samvangysegem/usb2uart-hardware/manufacturing/usb2uart-kicad.csv

Designator | Qty | Comment | Footprint | Manufacturer | MPN | LCSC Part #
C1,C2,C3,C4,C5,C6,C8,C12 | 8 | 0.1u | Capacitor_SMD:C_0402_1005Metric | Samsung | CL05B104KO5NNNC | C1525
C7 | 1 | 10u | Capacitor_SMD:C_0805_2012Metric_Pad1.18x1.45mm_HandSolder | Samsung | CL21A106KAYNNNE | C15850
C9 | 1 | 10u | Capacitor_SMD:C_0805_2012Metric | Samsung | CL21A106KAYNNNE | C15850
C10,C11 | 2 | 16p | Capacitor_SMD:C_0402_1005Metric | FH (Guangdong Fenghua Advanced Tech) | 0402CG150J500NT | C1548
D1 | 1 | TPD1E10B06 | Package_SON:Texas_DPY0002A_0.6x1mm_P0.65mm | Texas Instruments | TPD1E10B06DPYR | C48260
D2,D3,D4,D5,D6,D7,D8 | 7 | TPD2E2U06 | Package_TO_SOT_SMD:SOT-323_SC-70 | Texas Instruments | TPD2E2U06QDCKRQ1 | C915089
D9 | 1 | ACT_B | LED_SMD:LED_0603_1608Metric | Hubei KENTO Elec | KT-0603B | C2288
D10 | 1 | TX_R | LED_SMD:LED_0603_1608Metric | Hubei KENTO Elec | KT-0603R | C2286
D11 | 1 | RX_G | LED_SMD:LED_0603_1608Metric | Hubei KENTO Elec | KT-0603G | C12624
D12 | 1 | PWR_G | LED_SMD:LED_0603_1608Metric | Hubei KENTO Elec | KT-0603G | C12624
J1 | 1 | USB_C_16P | Connector_USB:USB_C_Receptacle_GCT_USB4105-xx-A_16P_TopMnt_Horizontal | SHOU HAN | TYPE-C 16PIN 2MD(073) | C2765186
J2,J3 | 2 | 530480510 | Connector_Molex:Molex_PicoBlade_53048-0510_1x05_P1.25mm_Horizontal | Molex | 530480510 | C588276
J4,J5 | 2 | 530480310 | Connector_Molex:Molex_PicoBlade_53048-0310_1x03_P1.25mm_Horizontal | MOLEX | 530480310 | C505275
R1,R2,R8,R9,R10 | 5 | 5k1 | Resistor_SMD:R_0402_1005Metric | UNI-ROYAL(Uniroyal Elec) | 0402WGF5101TCE | C25905
R3 | 1 | 0R | Resistor_SMD:R_0805_2012Metric_Pad1.20x1.40mm_HandSolder | UNI-ROYAL(Uniroyal Elec) | 0805W8F0000T5E | C17477
R4 | 1 | 390 | Resistor_SMD:R_0603_1608Metric_Pad0.98x0.95mm_HandSolder | UNI-ROYAL(Uniroyal Elec) | 0603WAF3900T5E | C23151
R5 | 1 | 820 | Resistor_SMD:R_0603_1608Metric_Pad0.98x0.95mm_HandSolder | UNI-ROYAL(Uniroyal Elec) | 0603WAF8200T5E | C23253
R6,R7 | 2 | 510 | Resistor_SMD:R_0603_1608Metric_Pad0.98x0.95mm_HandSolder | UNI-ROYAL(Uniroyal Elec) | 0603WAF5100T5E | C23193
U1 | 1 | CH344Q | Package_QFP:LQFP-48_7x7mm_P0.5mm | WCH | CH344Q | C2988084
U2 | 1 | SPX3819M5-L-3-3 | Package_TO_SOT_SMD:SOT-23-5 | MaxLinear | SPX3819M5-L-3-3/TR | C9055
X1 | 1 | 8MHz | Crystal:Crystal_SMD_3225-4Pin_3.2x2.5mm | YXC Crystal Oscillators | X32258MOB4SI | C2682775
