samvangysegem/usb2uart-hardware/usb2uart-kicad/usb2uart-kicad.kicad_pcb

## KiCad design usb2uart-kicad/usb2uart-kicad.kicad_pcb (2026-10-05)

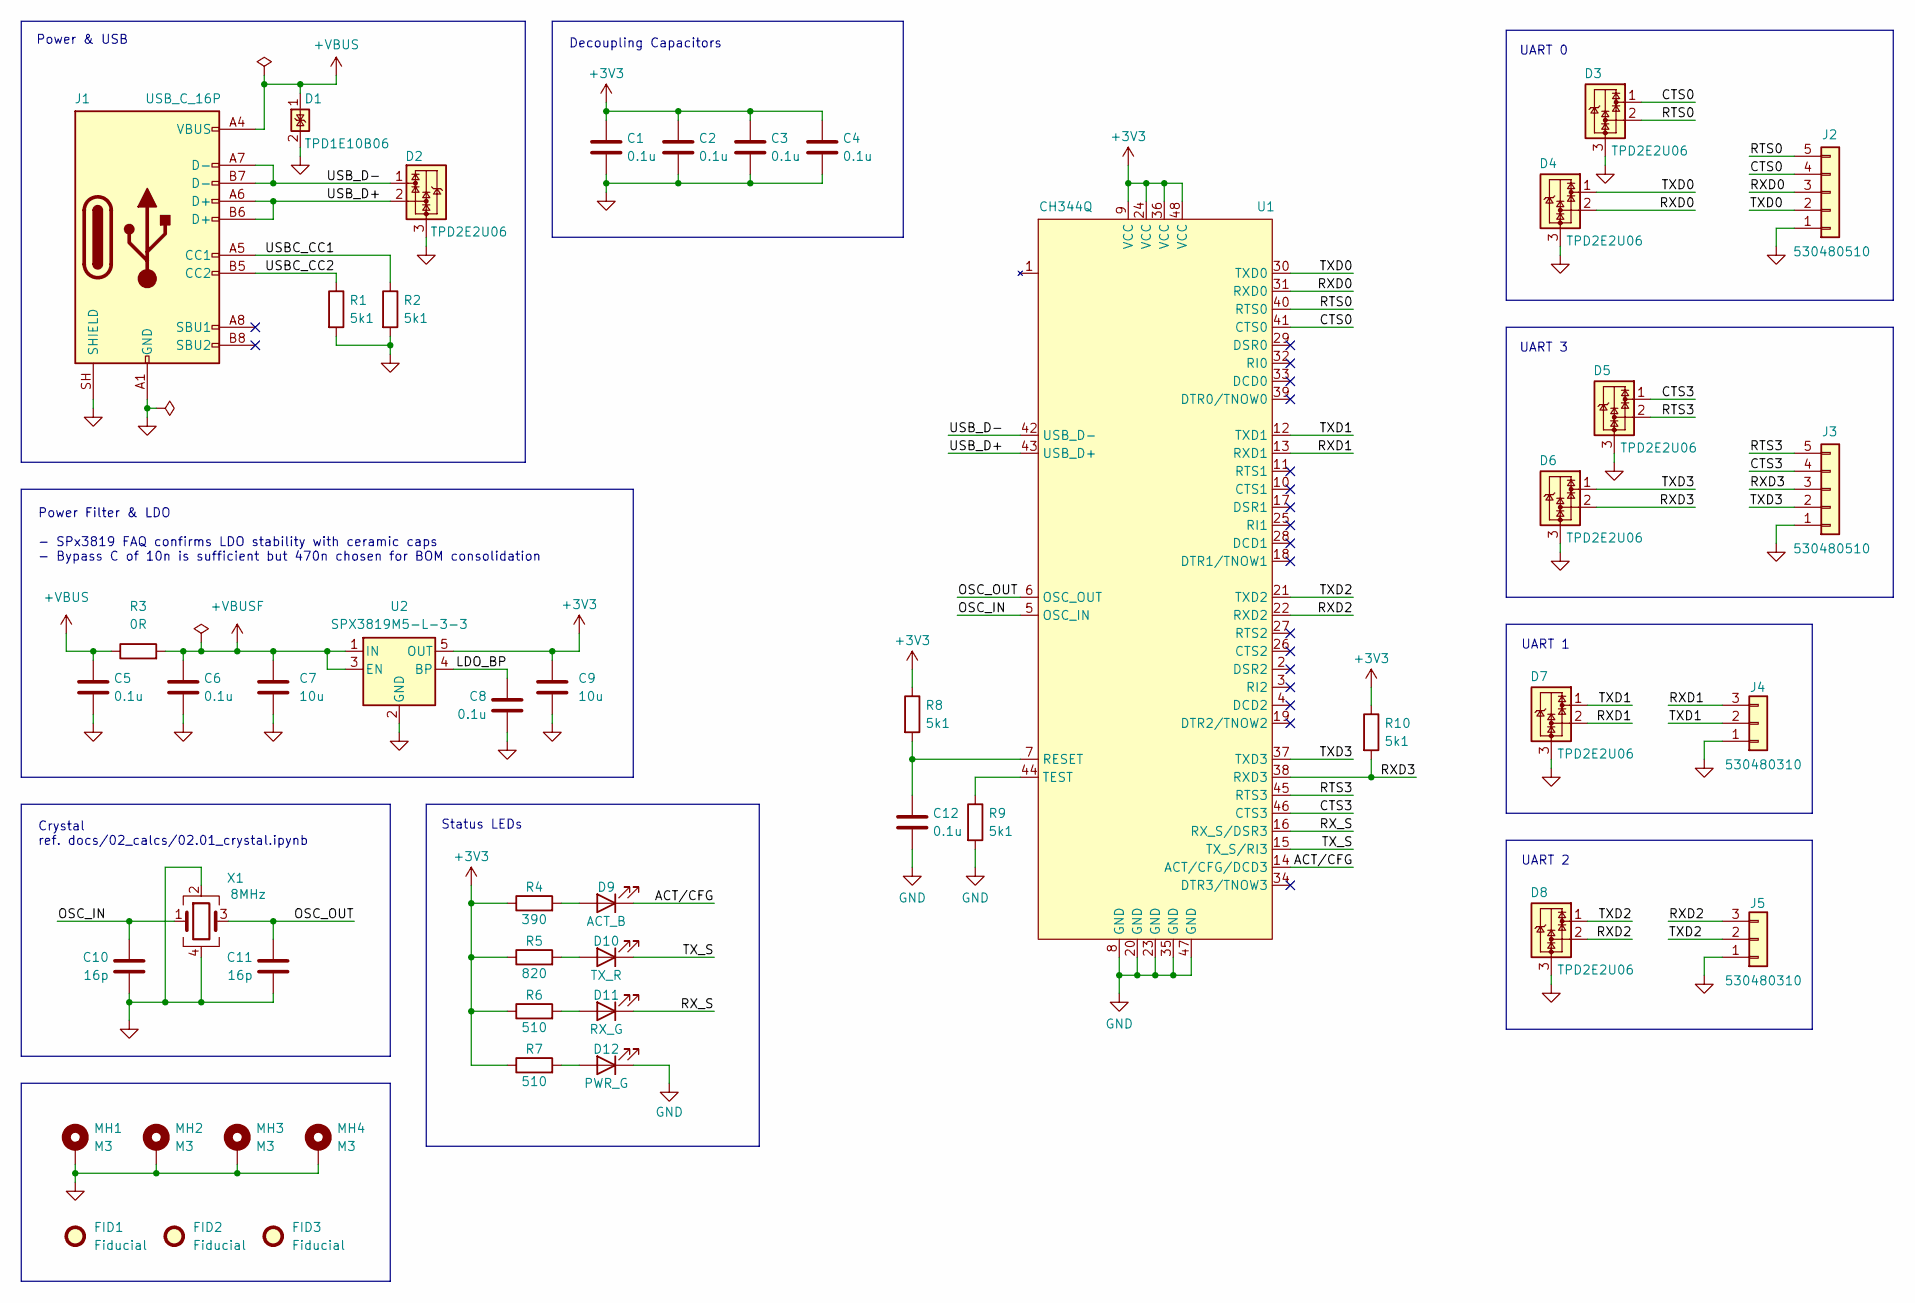
[picture p1: schematic usb2uart-kicad.kicad_sch, USB2UART Converter]

Parts:
C1, C2, C3, C4, C5, C6, C8, C12: 0.1u; C_0402_1005Metric; MPN CL05B104KO5NNNC; LCSC Part # C1525
C7: 10u; C_0805_2012Metric_Pad1.18x1.45mm_HandSolder; MPN CL21A106KAYNNNE; LCSC Part # C15850
C9: 10u; C_0805_2012Metric; MPN CL21A106KAYNNNE; LCSC Part # C15850
C10, C11: 16p; C_0402_1005Metric; MPN 0402CG150J500NT; LCSC Part # C1548
D1: TPD1E10B06; Texas_DPY0002A_0.6x1mm_P0.65mm; MPN TPD1E10B06DPYR; LCSC Part # C48260
D2, D3, D4, D5, D6, D7, D8: TPD2E2U06; SOT-323_SC-70; MPN TPD2E2U06QDCKRQ1; LCSC Part # C915089
D9: ACT_B; LED_0603_1608Metric; MPN KT-0603B; LCSC Part # C2288
D10: TX_R; LED_0603_1608Metric; MPN KT-0603R; LCSC Part # C2286
D11: RX_G; LED_0603_1608Metric; MPN KT-0603G; LCSC Part # C12624
D12: PWR_G; LED_0603_1608Metric; MPN KT-0603G; LCSC Part # C12624
FID1, FID2, FID3: Fiducial; Fiducial_1mm_Mask2mm
J1: USB_C_16P; USB_C_Receptacle_GCT_USB4105-xx-A_16P_TopMnt_Horizontal; MPN TYPE-C 16PIN 2MD(073); LCSC Part # C2765186
J2, J3: 530480510; Molex_PicoBlade_53048-0510_1x05_P1.25mm_Horizontal; MPN 530480510; LCSC Part # C588276
J4, J5: 530480310; Molex_PicoBlade_53048-0310_1x03_P1.25mm_Horizontal; MPN 530480310; LCSC Part # C505275
MH1, MH2, MH3, MH4: M3; MountingHole_3.2mm_M3_Pad_Via
R1, R2, R8, R9, R10: 5k1; R_0402_1005Metric; MPN 0402WGF5101TCE; LCSC Part # C25905
R3: 0R; R_0805_2012Metric_Pad1.20x1.40mm_HandSolder; MPN 0805W8F0000T5E; LCSC Part # C17477
R4: 390; R_0603_1608Metric_Pad0.98x0.95mm_HandSolder; MPN 0603WAF3900T5E; LCSC Part # C23151
R5: 820; R_0603_1608Metric_Pad0.98x0.95mm_HandSolder; MPN 0603WAF8200T5E; LCSC Part # C23253
R6, R7: 510; R_0603_1608Metric_Pad0.98x0.95mm_HandSolder; MPN 0603WAF5100T5E; LCSC Part # C23193
U1: CH344Q; LQFP-48_7x7mm_P0.5mm; MPN CH344Q; LCSC Part # C2988084
U2: SPX3819M5-L-3-3; SOT-23-5; MPN SPX3819M5-L-3-3/TR; LCSC Part # C9055
X1: 8MHz; Crystal_SMD_3225-4Pin_3.2x2.5mm; MPN X32258MOB4SI; LCSC Part # C2682775

Connections:
+3V3: C1.1, C2.1, C3.1, C4.1, C9.1, R4.1, R5.1, R6.1, R7.1, R8.1, R10.1, U1.9 (VCC), U1.24 (VCC), U1.36 (VCC), U1.48 (VCC), U2.5 (OUT)
+VBUS: C5.1, D1.1, J1.A4 (VBUS), J1.A9 (VBUS), J1.B4 (VBUS), J1.B9 (VBUS), R3.1
+VBUSF: C6.1, C7.1, R3.2, U2.1 (IN), U2.3 (EN)
/ACT/CFG: D9.1 (K), U1.14 (ACT/CFG/DCD3)
/CTS0: D3.1, J2.4, U1.41 (CTS0)
/CTS3: D5.1, J3.4, U1.46 (CTS3)
/LDO_BP: C8.1, U2.4 (BP)
/OSC_IN: C10.1, U1.5 (OSC_IN), X1.1
/OSC_OUT: C11.1, U1.6 (OSC_OUT), X1.3
/RTS0: D3.2, J2.5, U1.40 (RTS0)
/RTS3: D5.2, J3.5, U1.45 (RTS3)
/RXD0: D4.2, J2.3, U1.31 (RXD0)
/RXD1: D7.2, J4.3, U1.13 (RXD1)
/RXD2: D8.2, J5.3, U1.22 (RXD2)
/RXD3: D6.2, J3.3, R10.2, U1.38 (RXD3)
/RX_S: D11.1 (K), U1.16 (RX_S/DSR3)
/TXD0: D4.1, J2.2, U1.30 (TXD0)
/TXD1: D7.1, J4.2, U1.12 (TXD1)
/TXD2: D8.1, J5.2, U1.21 (TXD2)
/TXD3: D6.1, J3.2, U1.37 (TXD3)
/TX_S: D10.1 (K), U1.15 (TX_S/RI3)
/USBC_CC1: J1.A5 (CC1), R2.1
/USBC_CC2: J1.B5 (CC2), R1.1
/USB_D+: D2.2, J1.A6 (D+), J1.B6 (D+), U1.43 (USB_D+)
/USB_D-: D2.1, J1.A7 (D-), J1.B7 (D-), U1.42 (USB_D-)
GND: C1.2, C2.2, C3.2, C4.2, C5.2, C6.2, C7.2, C8.2, C9.2, C10.2, C11.2, C12.2, D1.2, D2.3, D3.3, D4.3, D5.3, D6.3, D7.3, D8.3, D12.1 (K), J1.A1 (GND), J1.A12 (GND), J1.B1 (GND), J1.B12 (GND), J1.SH (SHIELD), J2.1, J3.1, J4.1, J5.1, MH1.1 (1_1), MH2.1 (1_1), MH3.1 (1_1), MH4.1 (1_1), R1.2, R2.2, R9.2, U1.8 (GND), U1.20 (GND), U1.23 (GND), U1.35 (GND), U1.47 (GND), U2.2 (GND), X1.2, X1.4
unnamed: D9.2 (A), R4.2
unnamed: D10.2 (A), R5.2
unnamed: D11.2 (A), R6.2
unnamed: D12.2 (A), R7.2
unnamed: C12.1, R8.2, U1.7 (RESET)
unnamed: R9.1, U1.44 (TEST)

Notes on the sheet:
Crystal ref. docs/02_calcs/02.01_crystal.ipynb
Power Filter & LDO - SPx3819 FAQ confirms LDO stability with ceramic caps - Bypass C of 10n is sufficient but 470n chosen for BOM consolidation
UART 2
UART 1
UART 3
Status LEDs
Power & USB
UART 0
Decoupling Capacitors

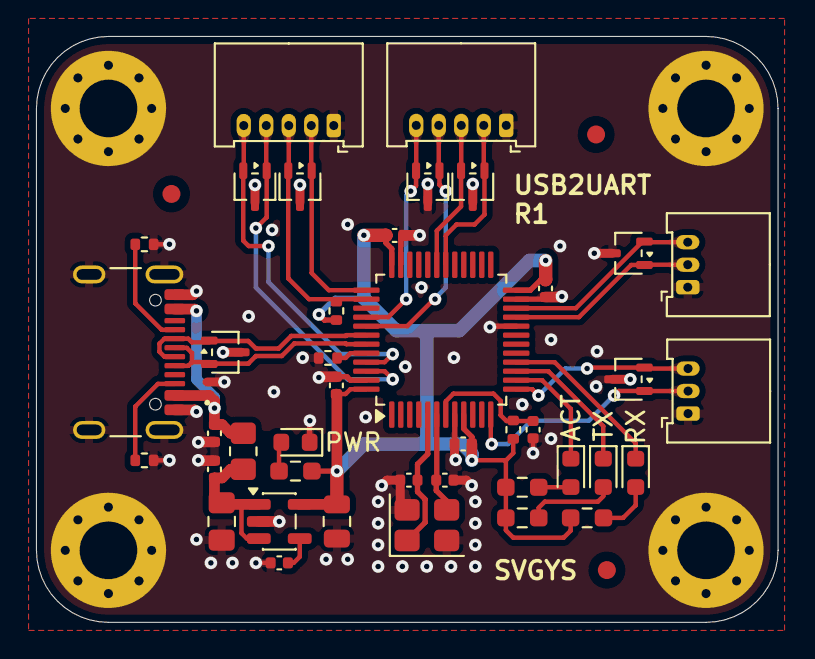
[picture p2: board usb2uart-kicad.kicad_pcb from above]

Board: 4 copper layers, 41.2 x 32.5 mm, 49 parts (0 on the bottom side), 32 nets.
